jusju/iltatahti/fem-moottoripukki/potkuripukki_V3_takareuna_FEM_koko_paketti-v2/tekstit/aiemmat_assistentin_vastaukset.md

# Aiemmat tässä chatissa näkyvät assistentin vastaukset

Tämä tiedosto sisältää keskustelun aiempien valmiiden vastausten olennaisen tekstin. Käyttäjän sanasta sanaan viestit ovat tiedostossa `keskustelu_ja_rajoitukset.md`. Work-tilan täysi transkriptio ei ollut palautettavissa.

## Ensimmäinen vertailu

Laskettiin neljä vaihtoehtoa: levytuki / V-tuki ja 5 mm / 10 mm sisäänmeno. Käytetyt mitat: runkoputki Ø10 mm, seinämä 0,8 mm, potkuriakseli Ø0,8 mm, akselilinjan etäisyys rungon keskeltä 12 mm, sivuveto 2°. Ensimmäisen suunnittelupaketin ilmoitetut PLA-massat: levytuki 5 mm 0,241 g, V-tuki 5 mm 0,231 g, levytuki 10 mm 0,412 g, V-tuki 10 mm 0,410 g. Yksinkertaistetun FEM:n akselisuuntaisen 1 N:n kuormituksen taipumaksi ilmoitettiin levylle 0,007006 mm ja 10 mm V-tuelle 0,00231 mm. Nämä ovat historiallisia, eivät nyt uudelleen vahvistettuja tuloksia. Huomautettiin, ettei kyse ole täydestä 3D-solid-FEM:stä.

## Sivuttais-V:n ja bio-version vertailu

Aiemmassa vastauksessa ilmoitettiin kuusi STL-mallia, STEP-mallit, CadQuery-lähdekoodi ja 8 sekunnin X/Y/Z MP4. 10 mm versioiden teoreettiset PLA-massat: levytuki 0,433 g, sivuttais-V 0,430 g ja bio 0,455 g. Suuntaa-antava palkki-FEM ennusti sivuttais-V:n noin 5,3-kertaisen Y-suuntaisen jäykkyyden levytukeen verrattuna; bio oli kompromissi Y- ja Z-jäykkyyksien välillä. Täyttä 3D-solid-FEM:iä tai matemaattista topologiaoptimointia ei ollut tehty. Suosituksena oli bio-rakenne jatkokehitykseen, ei todistetusti paras ratkaisu.

## Tämän version suunnitteluun annetut väliaikatiedot

Työn alussa todettiin, että viestien välissä ei ole tehty taustatyötä. Uusi tulostusasento suunniteltiin siten, että molempien holkkien alapäät ovat Z=0-tasossa, ja sivuttais-V-tuet nousevat alustasta. Ensimmäinen tarkistus osoitti levy- ja sivuttais-V-STL:t vesitiiviiksi, mutta bio-STL jäi epätiiviiksi. Sitä ei saa esittää tulostusvalmiina. Paketin tarkka massa-, vesitiiviys- ja geometrialoki on `massat_ja_tarkistus.json`.

## Sitaattien kattavuus

Edellä olevat kappaleet tiivistävät aiempien vastausten asiasisällön; ne eivät ole niiden täydellinen sanasta sanaan transkriptio. Täydet vanhat `LUE_MINUT.md`-asiakirjat on säilytetty muuttumattomina vanhoissa ZIP-tiedostoissa. Muuta alkuperäistä Work-transkriptiota ei ole saatavilla tässä istunnossa.
