jusju/iltatahti/bigsmash.pdf

### LEFT WING TIP

### 6% ARC WING FOIL SAME TEMPLATE FOR STAB

1.63 DIHEDRAL EACH TIP
(DOUBLE POLY
DIHEDRAL OPTIONAL
MAINTAIN 18"
MAX SPAN)

RUDDERS ATTACH
TO TOP OF RIBS

WING POSTS~
FIRM 3/32 x3" LONG
PAPER SOCKETS

WING POSTS
OFFSET .5"

### FRONT VIEW

### WING MAIN SPARS~FIRM ³ 32 WING TIP SPARS~FIRM ¹16 WING RIBS~MEDIUM ¹16 SLICED X ¹16 DEEP

### RUDDERS~ ALL MEDIUM ¹16 (BUILD TWO!) STAB SPARS~FIRM ¹16 STAB RIBS~MEDIUM ¹16 SLICED X ¹16DEEP (USE SAME TEMPLATE AS WING)

### MOTOR STICK~FIRM 3/16 OR 1/8 x 3/8 TALL x 10.5 LONG. TAPER ENDS

### TAILBOOM~FIRM 3/32 TAPERED FROM 1/4" TO 1/8" OVERLAP GLUE SEAM TO STAY UNDER 18" O.A.L PROP AND HANGAR~ ANY COMMERCIAL 6" PLASTIC PROP

### HANGAR UP TO BUILDER!

# BIG SMASH P-18

EAA INDOOR 2020 P-18 ONE DESIGN INSPIRED BY THE MASH-UP MUST CONFORM TO AMA P-18 RULES, WHICH BASICALLY SAY: ~MAX PROJECTED WING SPAN 18"
~MAX WING CHORD 4.5"
~MAX STAB SPAN 9", MAX STAB CHORD 3.5"
~MAX LENGTH INCLUDING PROP IS 18"
~MAX HOOK TO HOOK DISTANCE 10"
~MINIMUM WEIGHT 7.5 GRAMS
~COVERING TO BE TISSUE OR PLASTIC SHOPPING BAG MATERIAL ~PROP RULE: "The propeller shall be an unmodified commercially available plastic prop with a nominally maximum diameter of 6". If the propeller is advertised as being a 6" unit,it is acceptable for this event. Weight may be added for balancing."

ATTACH RUDDERS AT LEADING EDGE SO THAT TRAILING EDGE DOES NOT EXTEND BEYOND 18"

~WOOD SIZES ARE SUGGESTIONS. FEEL FREE TO CHANGE!
~COVERING SUGGESTION IS
PLASTIC VEGGIE BAG ADHERED WITH GLUE STICK.

INSPIRED BY THIS DOOD
