jusju/iltatahti/p-18_pursuit.pdf

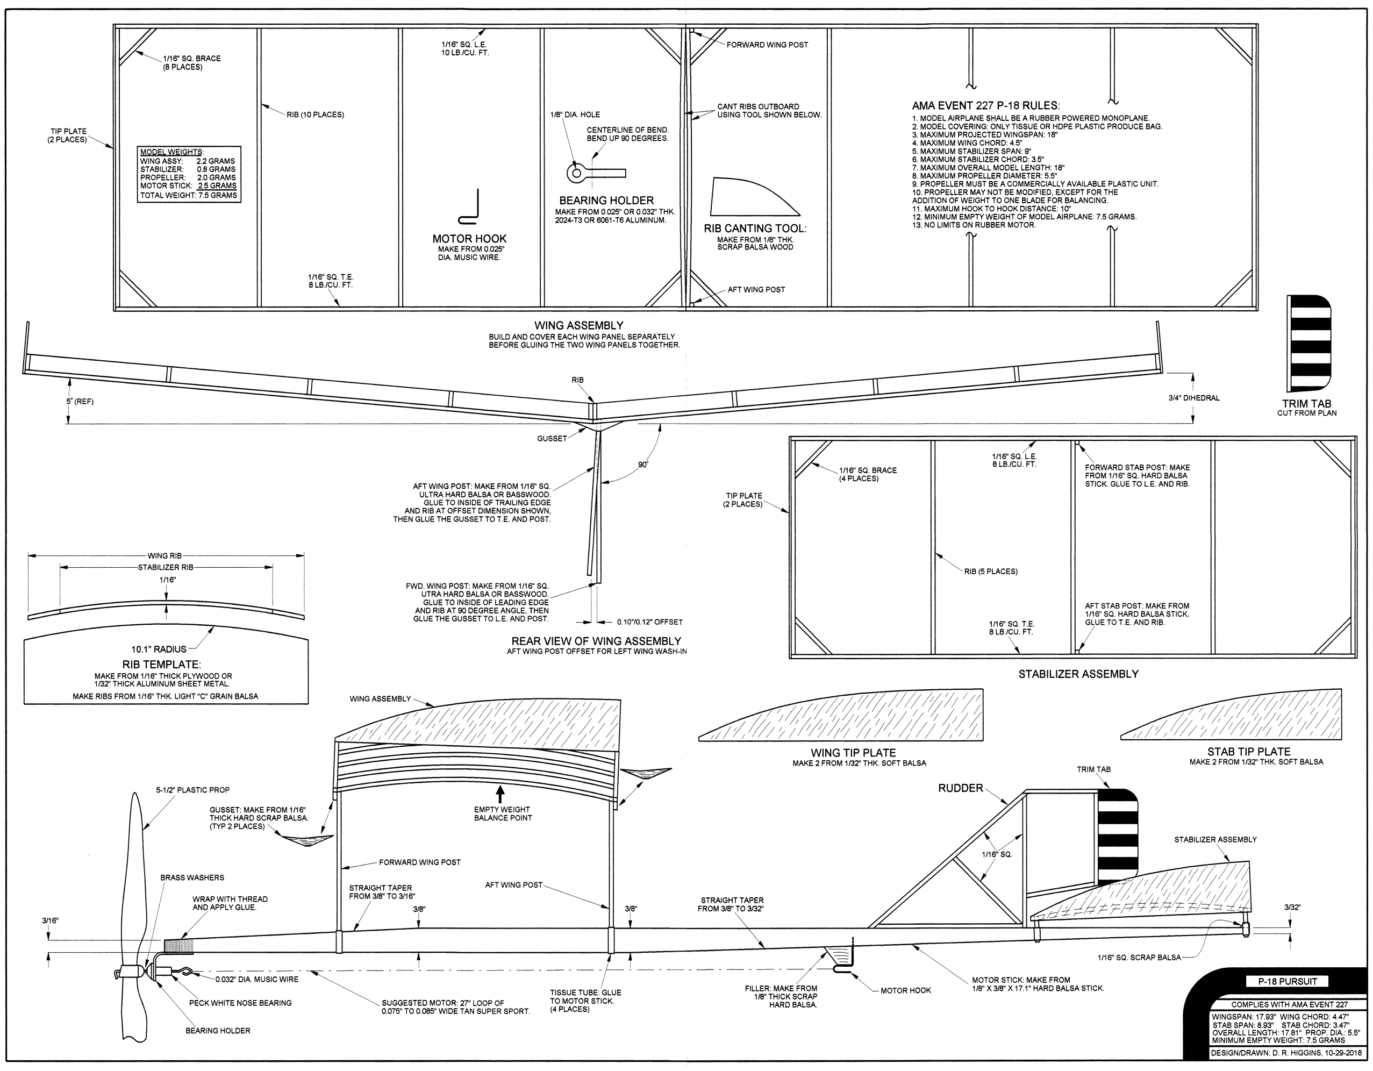
[picture p5: page 1]
