jusju/iltatahti/fem-moottoripukki/potkuripukki_V3_takareuna_FEM_koko_paketti-v2/animaatio/esikatselu.png

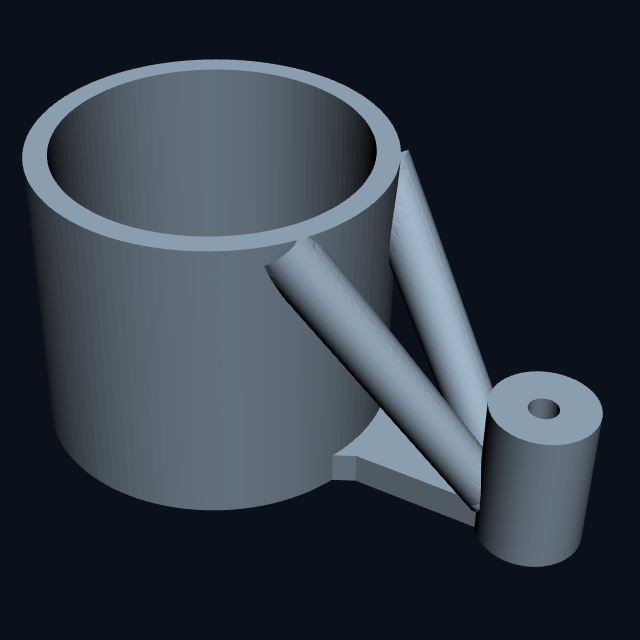
fem-moottoripukki/potkuripukki_V3_takareuna_FEM_koko_paketti-v2/animaatio/esikatselu.png
