jusju/iltatahti/fem-moottoripukki/potkuripukki_V3_takareuna_FEM_koko_paketti-v2/vertailu/V2_V3_10mm_FEM_muutos.png

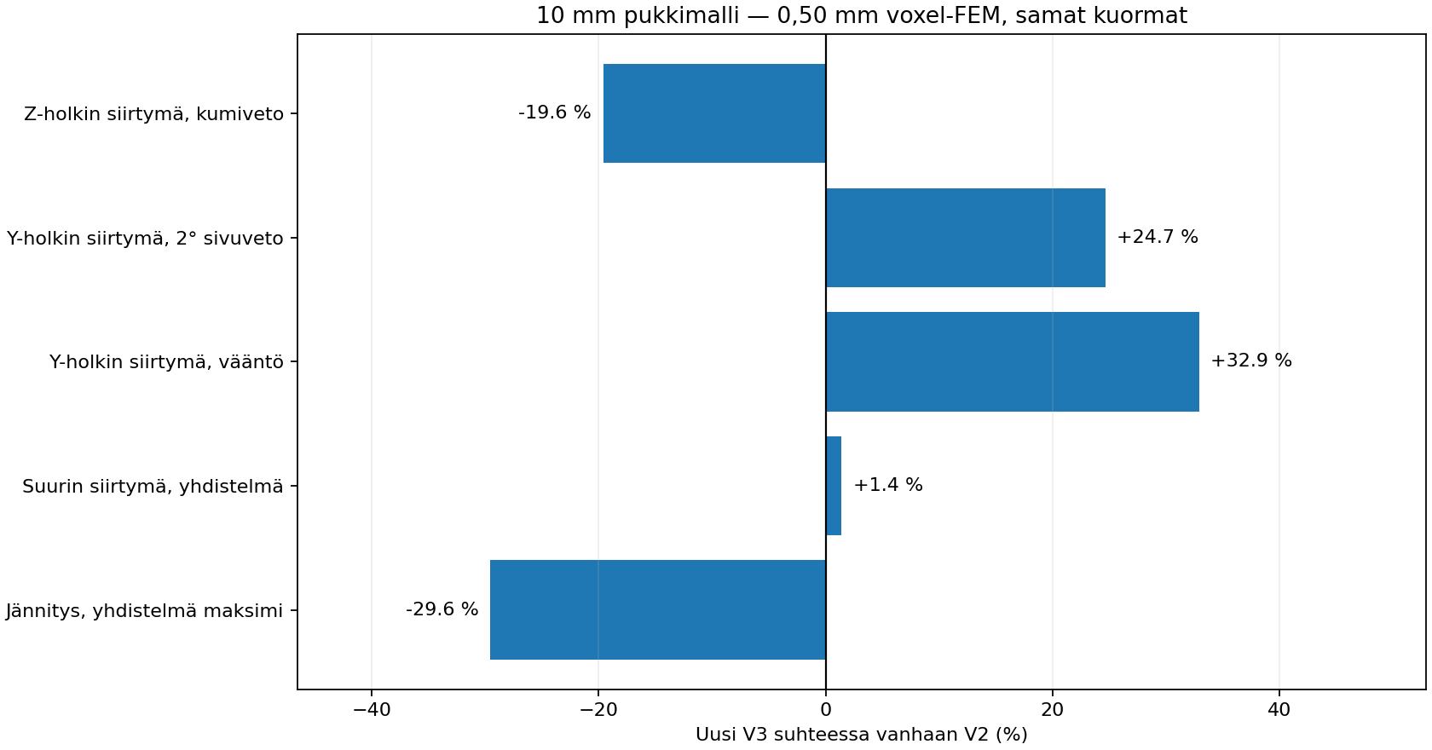
fem-moottoripukki/potkuripukki_V3_takareuna_FEM_koko_paketti-v2/vertailu/V2_V3_10mm_FEM_muutos.png
