jusju/iltatahti/p18_cruiser.pdf

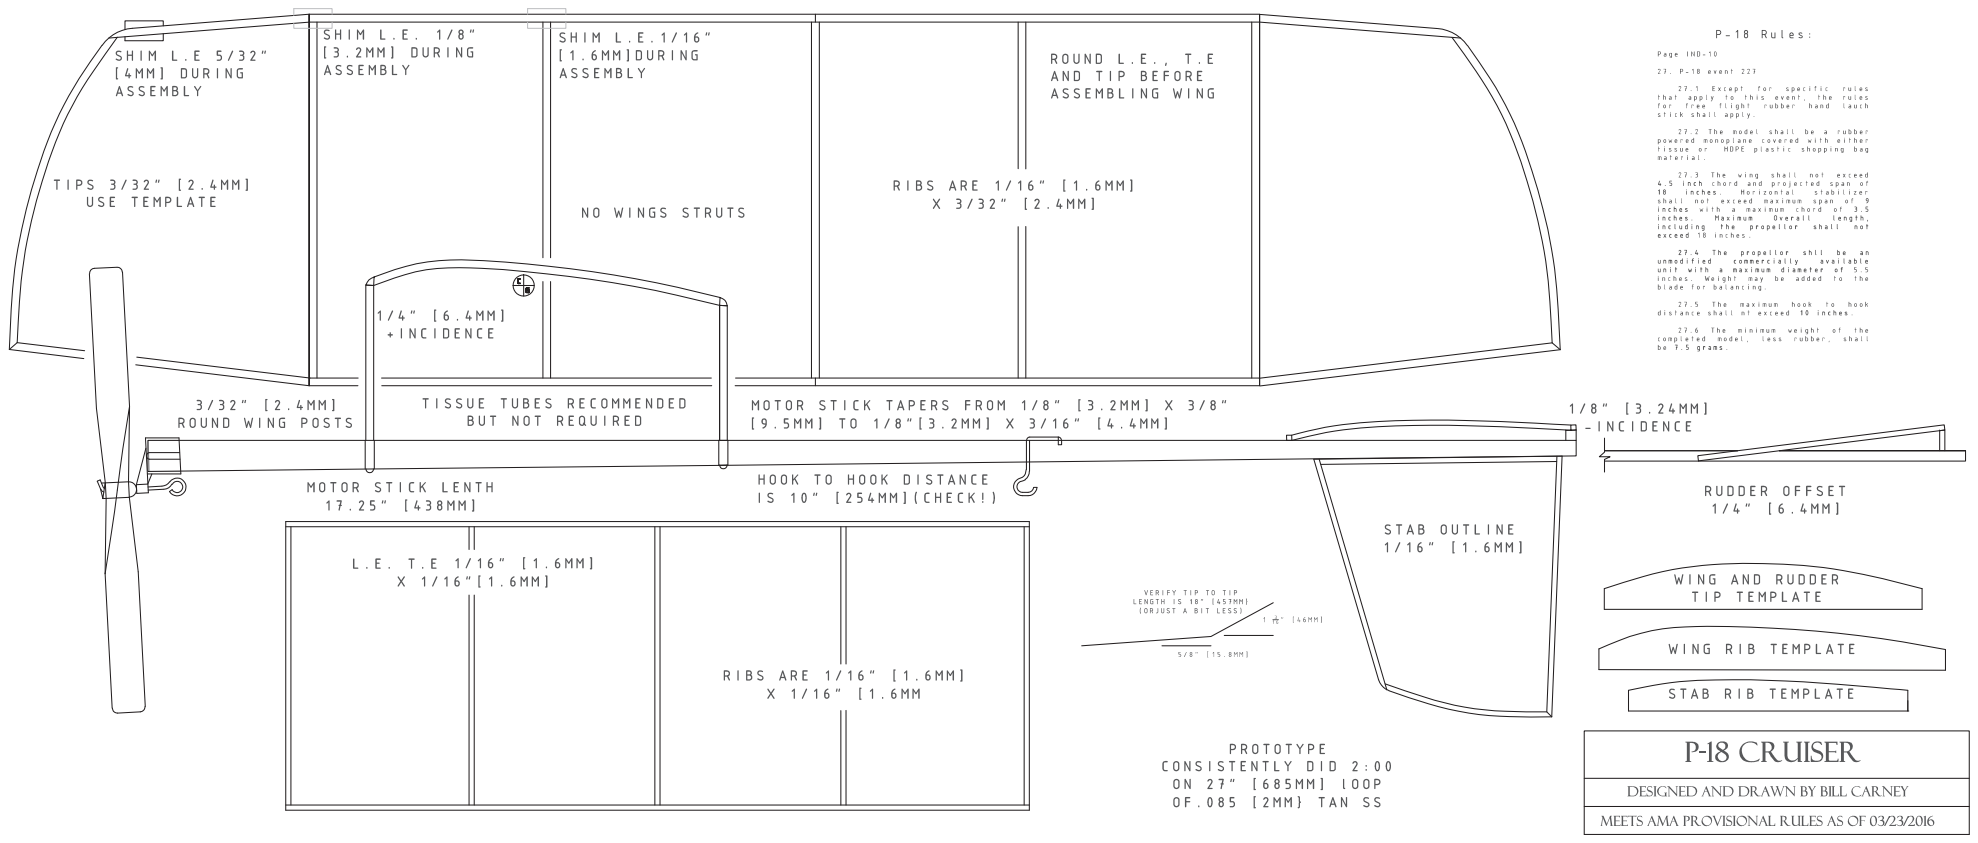
[picture p25: page 1]
