jusju/iltatahti/fem-moottoripukki/potkuripukki_korjattu_V_kaikki_tiedostot/mallit/pukki_plate_5mm_Z.step

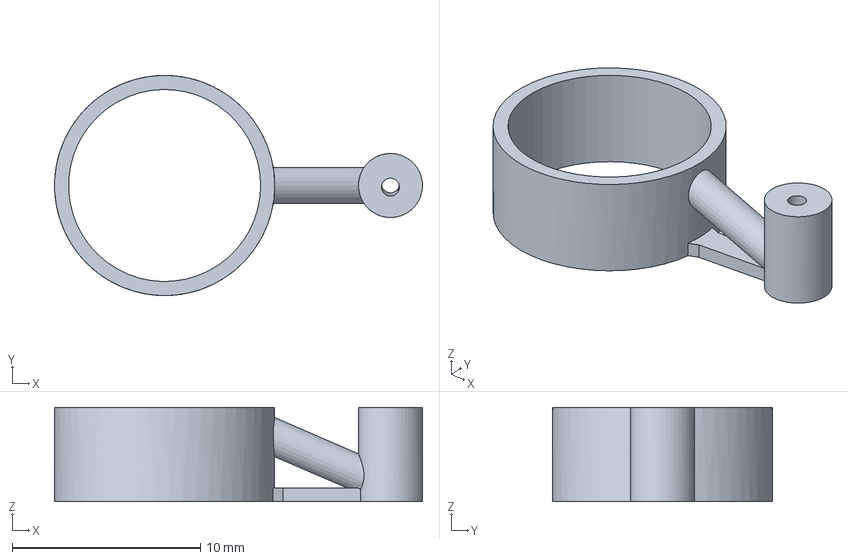
[picture p8: CAD file, 2026-11-01]
fem-moottoripukki/potkuripukki_korjattu_V_kaikki_tiedostot/mallit/pukki_plate_5mm_Z.step
19.5 x 11.7 x 5.00 mm
