jusju/iltatahti/hyttynen4-indoor-ff-supply-5cm-49cm.dxf

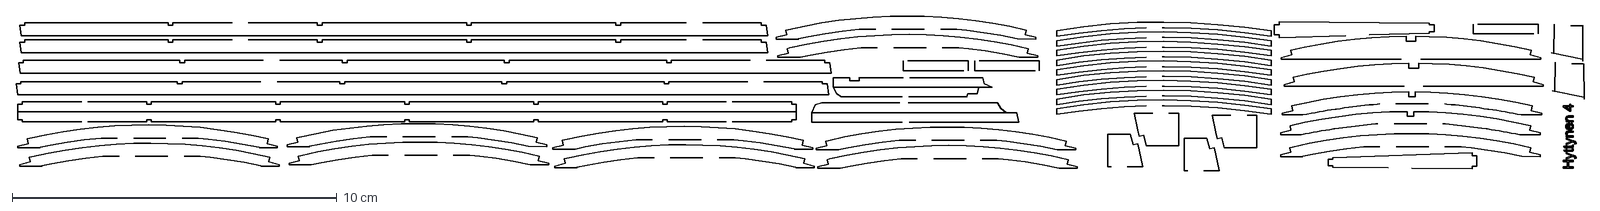
[picture p9: CAD file, 2026-11-01]
hyttynen4-indoor-ff-supply-5cm-49cm.dxf
48.3 x 4.77 cm
