jusju/iltatahti/step/potkuri_6_tuumaa_jigi_ala.step

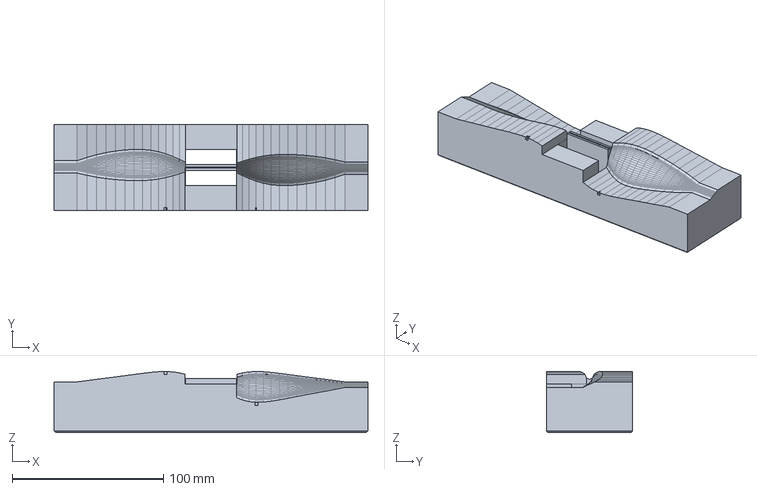
[picture p10: CAD file, 2026-11-01]
step/potkuri_6_tuumaa_jigi_ala.step
207.8 x 57.0 x 40.4 mm
