jusju/iltatahti/fem-moottoripukki/potkuripukki_V3_takareuna_FEM_koko_paketti-v2/mallit/pukki_V3_5mm_Z.step

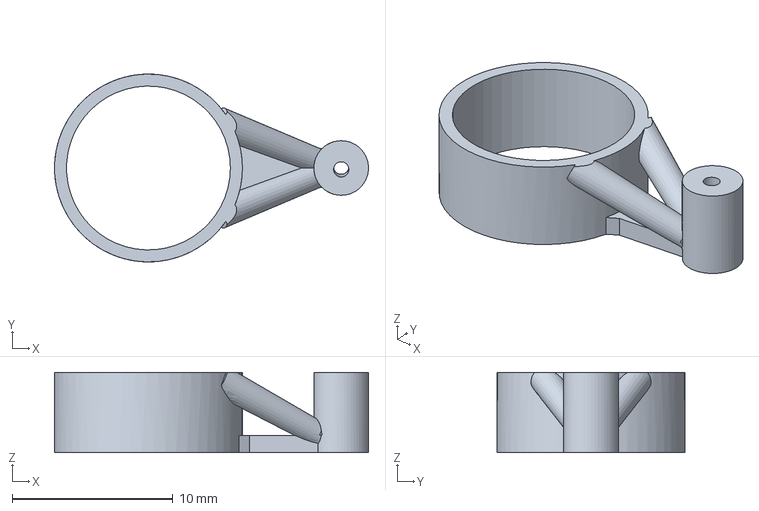
[picture p12: CAD file, 2026-11-01]
fem-moottoripukki/potkuripukki_V3_takareuna_FEM_koko_paketti-v2/mallit/pukki_V3_5mm_Z.step
19.5 x 11.7 x 5.00 mm
