jusju/iltatahti/pukki-v6.step

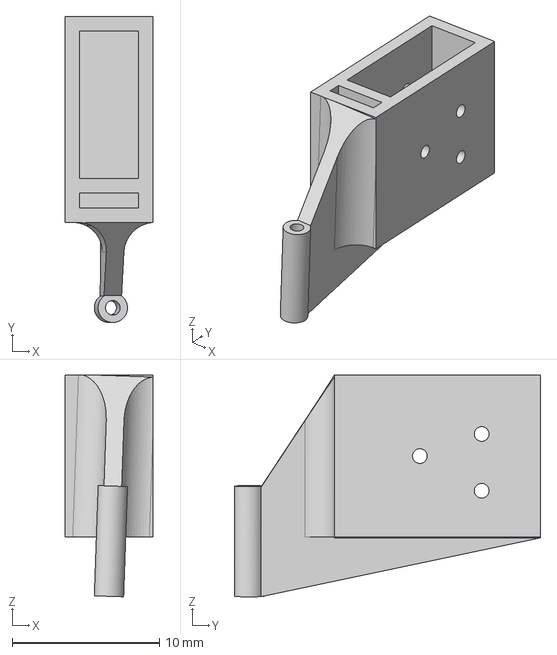
[picture p13: CAD file, 2026-11-01]
pukki-v6.step
6.00 x 20.8 x 15.1 mm
