jusju/iltatahti/step/potkuri_6_tuumaa_jigi_ala_1.stl

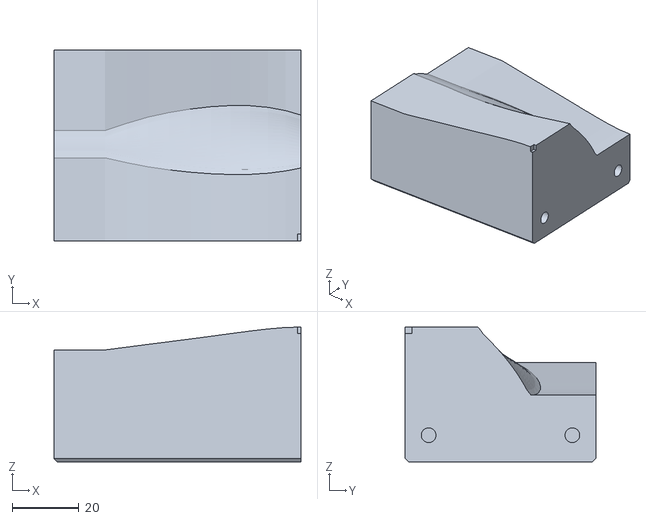
[picture p14: CAD file, 2026-11-01]
step/potkuri_6_tuumaa_jigi_ala_1.stl
73.9 x 57.0 x 40.4
