jusju/iltatahti/fem-moottoripukki/potkuripukki_korjattu_V_kaikki_tiedostot/mallit/pukki_V2_5mm_Z.step

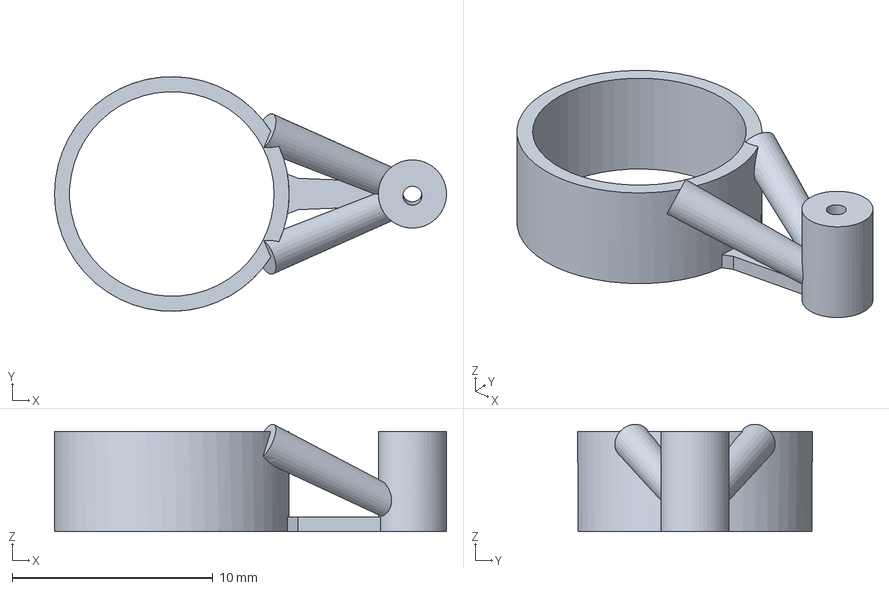
[picture p15: CAD file, 2026-11-01]
fem-moottoripukki/potkuripukki_korjattu_V_kaikki_tiedostot/mallit/pukki_V2_5mm_Z.step
19.5 x 11.7 x 5.35 mm
