jusju/iltatahti/fem-moottoripukki/potkuripukki_V3_takareuna_FEM_koko_paketti-v2/mallit/pukki_plate_10mm_Z.step

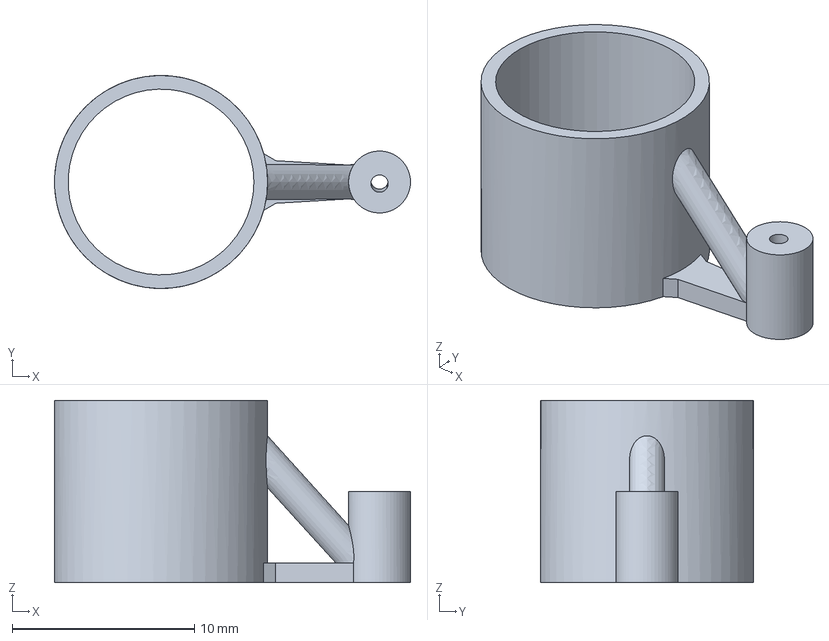
[picture p16: CAD file, 2026-11-01]
fem-moottoripukki/potkuripukki_V3_takareuna_FEM_koko_paketti-v2/mallit/pukki_plate_10mm_Z.step
19.5 x 11.7 x 10.0 mm
