jusju/iltatahti/step/pukki.step

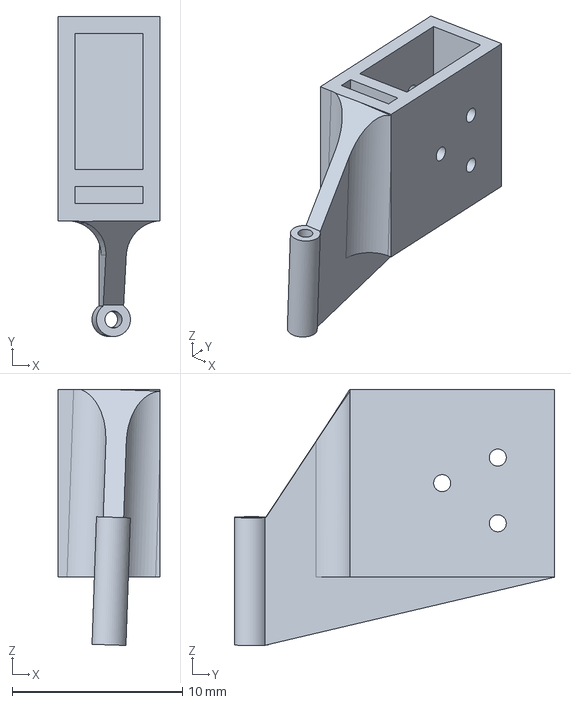
[picture p17: CAD file, 2026-11-01]
step/pukki.step
6.00 x 18.8 x 15.0 mm
