jusju/iltatahti/fem-moottoripukki/potkuripukki_korjattu_V_kaikki_tiedostot/mallit/pukki_V2_10mm_Z.step

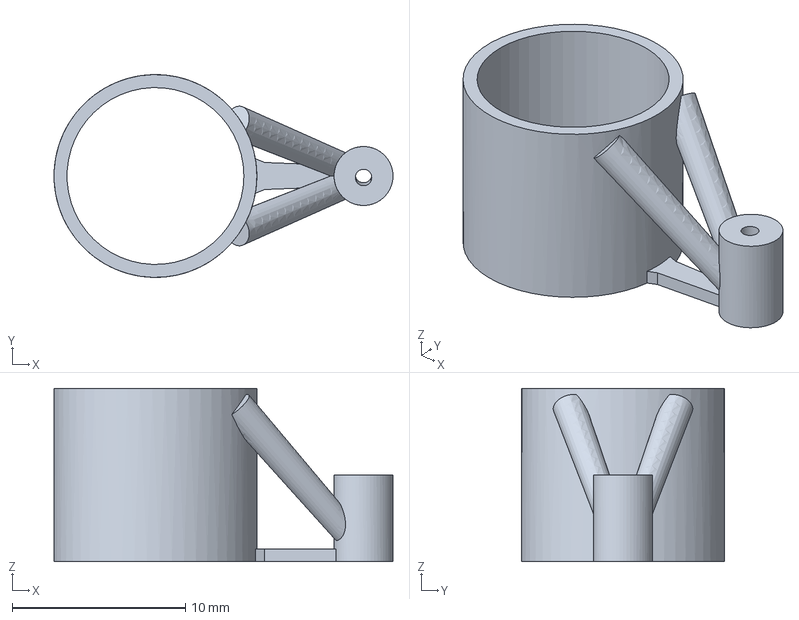
[picture p18: CAD file, 2026-11-01]
fem-moottoripukki/potkuripukki_korjattu_V_kaikki_tiedostot/mallit/pukki_V2_10mm_Z.step
19.5 x 11.7 x 10.0 mm
