jusju/iltatahti/step/6propeller.step

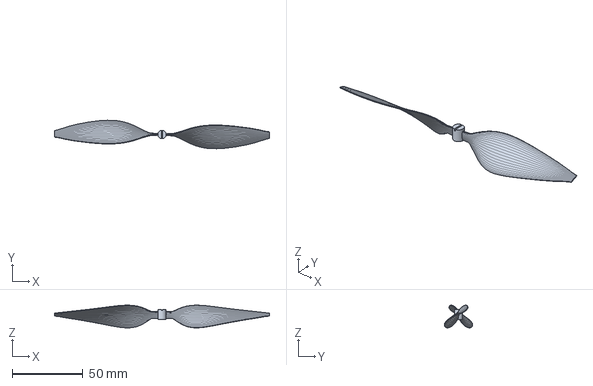
[picture p19: CAD file, 2026-11-01]
step/6propeller.step
151.8 x 20.1 x 16.0 mm
