jusju/iltatahti/step/jigi_tarkastus.step

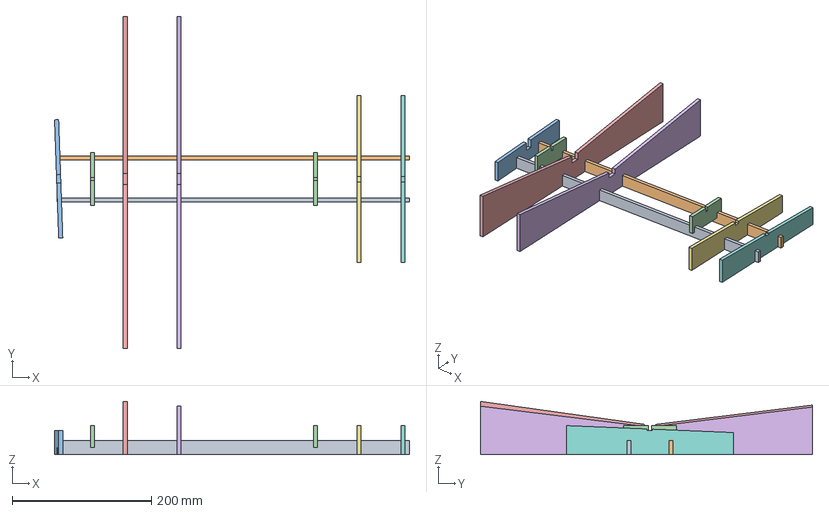
[picture p20: CAD file, 2026-11-01]
step/jigi_tarkastus.step
509.6 x 477.2 x 76.3 mm
1 kisko vasen
2 kisko oikea
3 potkurin vertailu
4 rungon etukannatin
5 rungon takakannatin
6 siiven johtoreunan vertailu
7 siiven jÃ¤ttÃ¶reunan vertailu
8 vakaajan johtoreunan vertailu
9 vakaajan jÃ¤ttÃ¶reunan vertailu
