jusju/iltatahti/step/6propeller_backoff.step

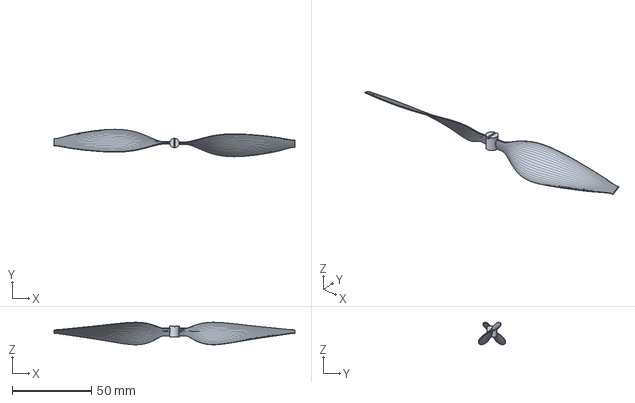
[picture p21: CAD file, 2026-11-01]
step/6propeller_backoff.step
151.8 x 17.3 x 14.2 mm
