jusju/iltatahti/step/jigi_vasen_siipi.step

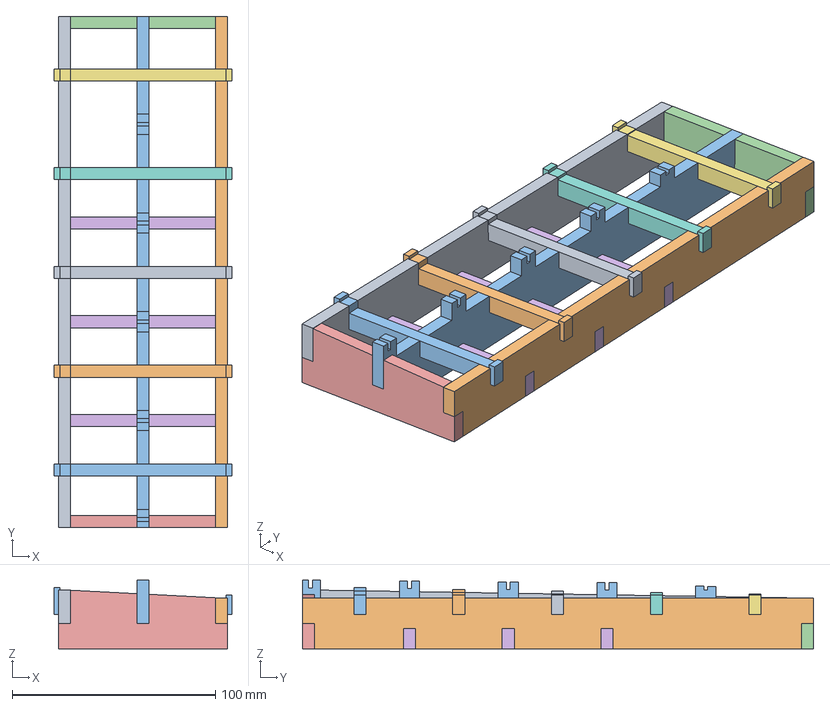
[picture p22: CAD file, 2026-11-01]
step/jigi_vasen_siipi.step
87.6 x 251.4 x 33.8 mm
1 johtoreunan seinÃ¤
2 jÃ¤ttÃ¶reunan seinÃ¤
3 keskiseinÃ¤ + haarukat
4 tyven seinÃ¤
5 kÃ¤rjen seinÃ¤
6 tukipala 1
7 tukipala 2
8 tukipala 3
9 ristikko 1
10 ristikko 2
11 ristikko 3
12 ristikko 4
13 ristikko 5
