jusju/iltatahti/step/iltatahti_p18.step

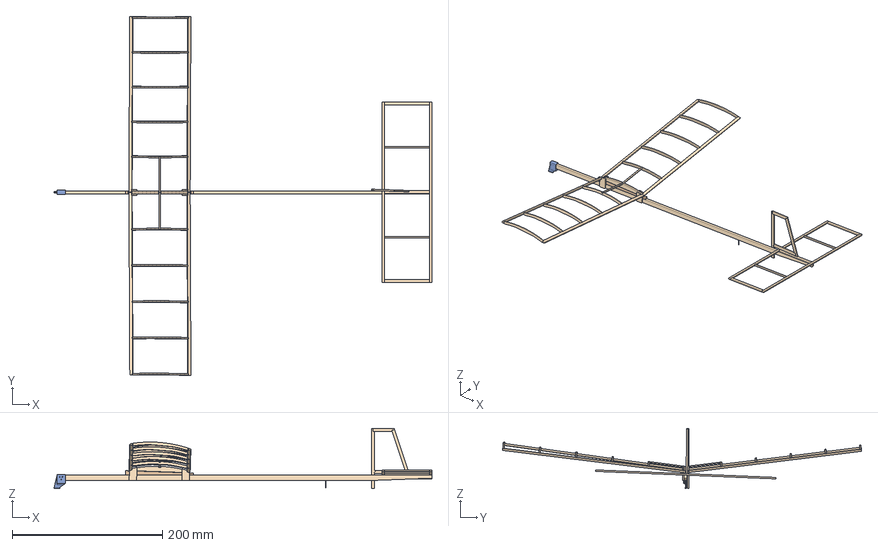
[picture p23: CAD file, 2026-11-01]
step/iltatahti_p18.step
502.0 x 477.2 x 80.1 mm
wing_L_le_spar
wing_L_te_spar
wing_L_rib0_8
wing_L_rib1_22
wing_L_rib2_2
wing_L_rib3_5
wing_L_rib4_30
wing_L_rib5_31
wing_L_center_spar
wing_L_leg_front_25
wing_L_leg_rear_35
wing_R_le_spar
wing_R_te_spar
wing_R_rib0_12
wing_R_rib1_27
wing_R_rib2_32
wing_R_rib3_33
wing_R_rib4_34
wing_R_rib5_37
wing_R_center_spar
wing_R_leg_front_26
wing_R_leg_rear_36
stab_le_spar_17
stab_te_spar_23
stab_rib0
stab_rib1
stab_rib2
stab_rib3
stab_rib4
fin_le
fin_root
fin_top
fin_te
motor_stick
wing_wedge
pukki
rear_hook
