jusju/iltatahti/step/potkuri_6_tuumaa_jigi_ala_2.stl

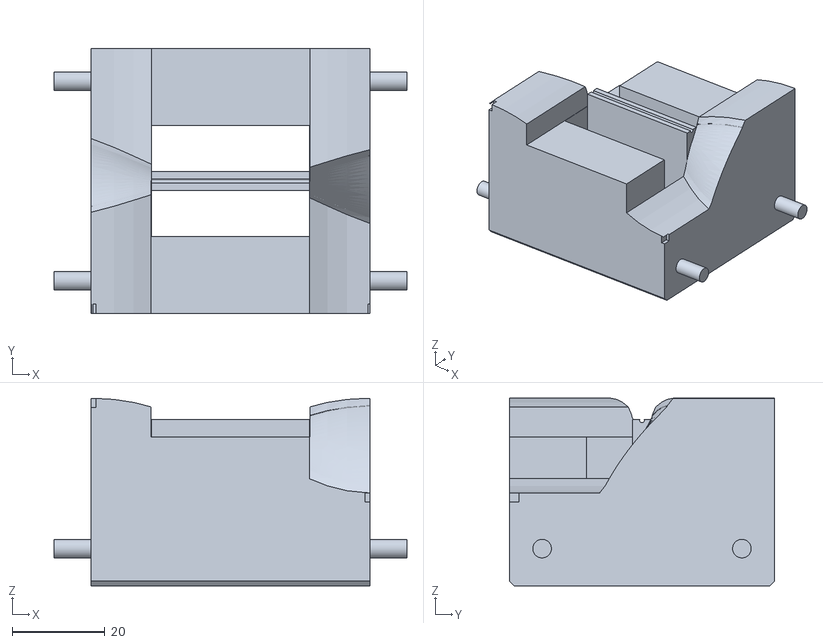
[picture p24: CAD file, 2026-11-01]
step/potkuri_6_tuumaa_jigi_ala_2.stl
76.0 x 57.0 x 40.4
