jusju/iltatahti/(list of files, cad)

Other CAD files:
fem-moottoripukki/potkuripukki_V3_takareuna_FEM_koko_paketti-v2/mallit/pukki_plate_5mm_Z.step
fem-moottoripukki/potkuripukki_V3_takareuna_FEM_koko_paketti-v2/mallit/pukki_V3_10mm_Z.step
step/potkuri_6_tuumaa_jigi_ala_3.stl
fem-moottoripukki/potkuripukki_V3_takareuna_FEM_koko_paketti-v2/mallit/pukki_V3_10mm_Z.stl
fem-moottoripukki/potkuripukki_V3_takareuna_FEM_koko_paketti-v2/mallit/pukki_V3_5mm_Z.stl
fem-moottoripukki/potkuripukki_V3_takareuna_FEM_koko_paketti-v2/mallit/pukki_plate_10mm_Z.stl
fem-moottoripukki/potkuripukki_V3_takareuna_FEM_koko_paketti-v2/mallit/pukki_plate_5mm_Z.stl
fem-moottoripukki/potkuripukki_korjattu_V_kaikki_tiedostot/mallit/pukki_V2_10mm_Z.stl
fem-moottoripukki/potkuripukki_korjattu_V_kaikki_tiedostot/mallit/pukki_V2_5mm_Z.stl
fem-moottoripukki/potkuripukki_korjattu_V_kaikki_tiedostot/mallit/pukki_plate_10mm_Z.stl
fem-moottoripukki/potkuripukki_korjattu_V_kaikki_tiedostot/mallit/pukki_plate_5mm_Z.stl
step/6propeller.stl
step/6propeller_backoff.stl
step/iltatahti_p18.stl
step/potkuri_6_tuumaa_jigi_ala.stl
step/pukki.stl
